fpicarras/hwsw-IST-24-25/lab1/prof_sources/app/image_conv2D_3ch_1ip.c

/**
 * @file image_conv2D.c
 * @date May, 2022
 *
 * Support file for lab1 of Hardware-Software Co-Design 2022
 *
 * Contains the baseline implementation of image convolution.
 */

#include <stdio.h>
#include <assert.h>
#include "image_conv2D_3ch_1ip.h"
#ifdef EMBEDDED
#include "xaxil_conv2d.h"
#endif

static unsigned char *ch_images;    /* images data region */
static unsigned char *image_in;     /* image to be processed */
static unsigned char *image_out;    /* output image */
static unsigned char *hw_image_out; /* output image computed using the hardware */

void sw_convolution_2D(const unsigned char *matrix_in, unsigned char *matrix_out) {
    for (int i = 0; i < OUTPUT_HEIGHT; i++)
        for (int j = 0; j < OUTPUT_WIDTH; j++) {
            int accum = bias;                       // initialize result with bias

            for (int k = 0; k < KERNEL_SIZE; k++)
                for (int x = 0; x < KERNEL_SIZE; x++) {
                    // Kernel index
                    int kernel_1d_idx =
                            k * KERNEL_SIZE +       // kernel row
                            x;                      // kernel column

                    // Input matrix index 
                    int input_1d_idx =
                            (i + k) * IMAGE_WIDTH + // input row
                            j + x;                  // input column

                    accum += kernel[kernel_1d_idx] * matrix_in[input_1d_idx];
                }

            // Normalize result
            if (accum > 255)
                accum = 255;
            else if (accum < 0)
                accum = 0;

            matrix_out[i * OUTPUT_WIDTH + j] = accum;
        }
}

void print_ppm(unsigned char *image, int height, int width, const char *prefix, int suffix){
#ifndef EMBEDDED
    char filename[STRING_LENGTH];
    sprintf(filename, "%s_image_%d.ppm", prefix, suffix);

    /* Open image file */
    FILE *image_file = fopen(filename, "wb");
    assert(image_file);

    printf("Printing %s image %d to file %s\n\r", prefix, suffix, filename);
#else
    FILE *image_file = stdout;
#endif //EMBEDDED

    /* Print binary PPM header */
    fprintf(image_file, "P6\n%d %d\n255\n", width, height);

    /* Write binary RGB pixel data */
    for (int i = 0; i < height; i++) {
         for(int j = 0; j < width; j++) {
             fputc(IMAGE_R(image, height, width, i, j), image_file);
             fputc(IMAGE_G(image, height, width, i, j), image_file);
             fputc(IMAGE_B(image, height, width, i, j), image_file);
        }
    }

    fprintf(image_file, "\n");


#ifndef EMBEDDED
    fclose(image_file);
#endif //EMBEDDED
}

void HWSW_conv2D(const unsigned char *matrix_in, unsigned char *matrix_out) {
#ifdef HLS_SIMULATION

    /* =====================================================================================
     * ======== DEVELOP THE HLS ROUTINE TO SIMULATE DE HARDWARE IP BELOW THIS LINE! ========
     * ===================================================================================== */
    sw_convolution_2D(matrix_in, matrix_out);
    sw_convolution_2D(matrix_in + IMAGE_HEIGHT*IMAGE_WIDTH, matrix_out + OUTPUT_HEIGHT*OUTPUT_WIDTH);
    sw_convolution_2D(matrix_in + 2*IMAGE_HEIGHT*IMAGE_WIDTH, matrix_out + 2*OUTPUT_HEIGHT*OUTPUT_WIDTH);

#elif defined(USE_HW_IP)
    /* =====================================================================================
     * ========== DEVELOP THE ROUTINE TO CONTROL DE HARDWARE IP BELOW THIS LINE! ===========
     * ===================================================================================== */    
    // Initialize temporary memmory
    unsigned int *tmp_in = (unsigned int *) MEM_INPUT_TMP_ADDRESS;
    unsigned int *tmp_out = (unsigned int *) MEM_OUTPUT_TMP_ADDRESS;
    unsigned int tmp;

    for(int i = 0; i < IMAGE_HEIGHT; i++){
        for(int j = 0; j < IMAGE_WIDTH; j++){
            tmp = (unsigned int) IMAGE_R(matrix_in, IMAGE_HEIGHT, IMAGE_WIDTH, i, j);
            tmp += ((unsigned int) IMAGE_G(matrix_in, IMAGE_HEIGHT, IMAGE_WIDTH, i, j)) << 8;
            tmp += ((unsigned int) IMAGE_B(matrix_in, IMAGE_HEIGHT, IMAGE_WIDTH, i, j)) << 16;
            tmp_in[i*IMAGE_WIDTH+j] = tmp;
        }
    }
    
    // Initialize IP
    XAxil_conv2d conv2d_0;
    XAxil_conv2d_Config *cfg_0;
    cfg_0 = XAxil_conv2d_LookupConfig(0x40000000);
    XAxil_conv2d_CfgInitialize(&conv2d_0, cfg_0);
    
    // Set Inputs on all channels
    while(!XAxil_conv2d_IsReady(&conv2d_0));    
    XAxil_conv2d_Write_image_in_Words(&conv2d_0, 0, tmp_in, IMAGE_HEIGHT * IMAGE_WIDTH);
    XAxil_conv2d_Write_weights_Bytes(&conv2d_0, 0, kernel, KERNEL_SIZE * KERNEL_SIZE);
    XAxil_conv2d_Set_bias(&conv2d_0, bias);
    XAxil_conv2d_Start(&conv2d_0);

    while(!XAxil_conv2d_IsDone(&conv2d_0));
    XAxil_conv2d_Read_image_out_Bytes(&conv2d_0, 0, tmp_in, 4*OUTPUT_HEIGHT*OUTPUT_WIDTH);

    for(int i = 0; i < OUTPUT_HEIGHT; i++){
        for(int j = 0; j < OUTPUT_WIDTH; j++){
            tmp = tmp_in[i*OUTPUT_WIDTH + j];
            IMAGE_R(matrix_out, OUTPUT_HEIGHT, OUTPUT_WIDTH, i, j) = (unsigned char)tmp;
            IMAGE_G(matrix_out, OUTPUT_HEIGHT, OUTPUT_WIDTH, i, j) = (unsigned char)(tmp >> 8);
            IMAGE_B(matrix_out, OUTPUT_HEIGHT, OUTPUT_WIDTH, i, j) = (unsigned char)(tmp >> 16);
        }
    }

#endif //HLS_SIMULATION/USE_HW_IP
}

int check_hw_errors() {
    int err_cnt = 0;
    for (int i = 0; i < (OUTPUT_HEIGHT * OUTPUT_WIDTH * 3); i++)
        if (hw_image_out[i] != image_out[i]) {
            err_cnt++;
            // printf("%d: %d != %d\n\r", i, hw_image_out[i], image_out[i]);
        }

    return err_cnt;
}

int main() {

    printf("Hi!\n");
    /* Performs memory assignment  */
    ch_images = (unsigned char *) MEM_IMAGES_BASE_ADDRESS;
    image_out = (unsigned char *) MEM_DATA_BASE_ADDRESS;
    hw_image_out = (unsigned char *) MEM_OUTPUT_BASE_ADDRESS;

#ifndef EMBEDDED
    /* Read images from file */
    FILE *images_file = fopen(IMAGES_FILENAME, "rb");
    assert(images_file);
    fread(ch_images, N_IMAGES * IMAGE_SIZE, 1, images_file);
    for(int i = 0; i < N_IMAGES * IMAGE_SIZE; i++) {
        printf("%x, ", ch_images[i]);
        if((i+1)%IMAGE_HEIGHT == 0) {
            printf("\n\n\n");
        }
    }
    fclose(images_file);
#endif //EMBEDDED

    /* Select input image */
    image_in = ch_images + (IMAGE_TO_CONVOLVE - 1) * IMAGE_SIZE;

#ifdef EMBEDDED
    XTime tStart, tEnd;
    XTime_GetTime(&tStart);
#endif //EMBEDDED

    /* Performs software convolution */
    sw_convolution_2D(image_in,
                      image_out);                                    /* Red channel */
    sw_convolution_2D(image_in + IMAGE_HEIGHT * IMAGE_WIDTH,
                      image_out + OUTPUT_HEIGHT * OUTPUT_WIDTH);     /* Green channel */
    sw_convolution_2D(image_in + 2 * IMAGE_HEIGHT * IMAGE_WIDTH,
                      image_out + 2 * OUTPUT_HEIGHT * OUTPUT_WIDTH); /* Blue channel */

#ifdef EMBEDDED
    XTime_GetTime(&tEnd);
    XTime tSW = tEnd - tStart;
#endif //EMBEDDED

#if defined(HLS_SIMULATION) || defined(USE_HW_IP)
#ifdef EMBEDDED
    XTime_GetTime(&tStart);
#endif //EMBEDDED

    /* Performs hardware convolution */
    printf("Running HW!\n");
    HWSW_conv2D(image_in,
                hw_image_out);                                    /* Red channel */
    printf("Done HW!\n");
    //HWSW_conv2D(image_in + IMAGE_HEIGHT * IMAGE_WIDTH,
    //            hw_image_out + OUTPUT_HEIGHT * OUTPUT_WIDTH);     /* Green channel */
    //HWSW_conv2D(image_in + 2 * IMAGE_HEIGHT * IMAGE_WIDTH,
    //            hw_image_out + 2 * OUTPUT_HEIGHT * OUTPUT_WIDTH); /* Blue channel */

#ifdef EMBEDDED
    XTime_GetTime(&tEnd);
    XTime tHW = tEnd - tStart;
#endif //EMBEDDED

    int errs = check_hw_errors();
#endif //HLS_SIMULATION || USE_HW_IP

#ifdef EMBEDDED
    printf("# SW Execution: %.2f ms.\n\r", (float) tSW * 1000 / (COUNTS_PER_SECOND));

#ifdef USE_HW_IP
    printf("# HW Execution: %.2f ms.\n\r", (float) tHW * 1000 / (COUNTS_PER_SECOND));
    printf("# Speedup: %.2f.\n\r", (float) tSW / tHW);
    printf("# Errors: %d\n\r", errs);
#endif //USE_HW_IP
#endif //EMBEDDED

#ifdef PRINT_IMAGE_IN
    print_ppm(image_in, IMAGE_WIDTH, IMAGE_HEIGHT, "input", IMAGE_TO_CONVOLVE);
#endif //PRINT_IMAGE_IN

    // for(int i = 0; i < OUTPUT_HEIGHT * OUTPUT_WIDTH; i++) {
    //     printf("%x, ", image_out[i]);
    //     if((i+1)%IMAGE_HEIGHT == 0) {
    //         printf("\n\n\n");
    //     }
    // }

#ifdef PRINT_IMAGE_OUT
    print_ppm(image_out, OUTPUT_HEIGHT, OUTPUT_WIDTH, "output", IMAGE_TO_CONVOLVE);
#endif //PRINT_IMAGE_OUT

#ifdef HLS_SIMULATION
    return errs;
#else
    return 0;
#endif
}
