fpicarras/hwsw-IST-24-25/app/gemm.h

#ifndef __GEMM_H__
#define __GEMM_H__

#include <stdint.h>

#define BLOCK_SIZE 32 // Block size for tiling

/**
 * Computes matrix multiplication using the GEMM kernel.
 * @param A Gathered matrix A
 * @param B Matrix B
 * @param C Output matrix
 * @param rowsA Rows of matrix A
 * @param colsA Columns of matrix A
 * @param colsB Columns of matrix B
 */
void gemm(const float *A, const float *B, float *C, int rowsA, int colsA, int colsB);

/**
 * Computes matrix multiplication using the GEMM kernel and sums with a bias.
 * @param A Gathered matrix A
 * @param B Matrix B
 * @param bias Bias
 * @param C Output matrix
 * @param rowsA Rows of matrix A
 * @param colsA Columns of matrix A
 * @param colsB Columns of matrix B
 */
void gemmBias(const int16_t *A, const int32_t *B, const int16_t* bias, float *C, int rowsA, int colsA, int colsB);


void gemvOpt(const int16_t *A, const int32_t *B, const int16_t* bias, int64_t *C);

void gemvOptT(const int16_t *A, const int32_t *B, const int16_t* bias, int64_t *C);

/**
 * Computes matrix multiplication using the GEMM kernel with second matrix transposed.
 * @param A Gathered matrix A
 * @param BT Matrix B transposed
 * @param C Output matrix
 * @param rowsA Rows of matrix A
 * @param colsA Columns of matrix A
 * @param rowsBT Rows of matrix B transposed (columns of matrix B)
 */
void gemmBT(const float *A, const float *BT, float *C, int rowsA, int colsA, int rowsBT);

/**
 * Computes matrix multiplication using the GEMM kernel with second matrix transposed.
 * and transposes the result.
 * @param A Gathered matrix A
 * @param BT Matrix B transposed
 * @param CT Output matrix (transposed)
 * @param rowsA Rows of matrix A
 * @param colsA Columns of matrix A
 * @param rowsBT Rows of matrix B transposed (columns of matrix B)
 */
void gemmBTCT(const float *A, const float *BT, float *CT, int rowsA, int colsA, int rowsBT);

/**
 * Transposes matrix.
 * @param C Input matrix
 * @param rows Rows of input matrix
 * @param cols Columns of input matrix
 * @param CT Output matrix (transposed input matrix)
 */
void transpose(const float *C, int rows, int cols, float *CT);

void transpose_int(const int16_t *C, int rows, int cols, int16_t * CT);

/**
 * Adds bias to all elements of the input matrix.
 * @param C Input matrix
 * @param rows Rows of input matrix
 * @param cols Columns of input matrix
 * @param bias Bias
 * @param Cbias Output matrix
 */
void add_bias(const float *C, int rows, int cols, const float *bias, float *Cbias);

/**
 * Applies ReLU to elements of input matrix.
 * @param C Input matrix
 * @param size Size of input matrix
 * @param Crl Output matrix
 */
void ReLU(const float *C, int size, float *Crl);

#endif // __GEMM_H__
