fpicarras/hwsw-IST-24-25/app/simple_cnn.c

/**
 * @file simple_cnn.c
 * @date May, 2022
 *
 * Support file for lab2 of Hardware-Software Co-Design 2022
 *
 * Contains the variables, constants, and routines related to the CNN model, as well as the main routine.
 *
 * NOTES:
 * 1) With the default memory management scheme, images.bin and weights.bin should
 *    be stored in the following memory locations:
 *    images.bin  -> 0x10000000
 *    weights.bin -> 0x11000000
 * 2) When generating the linker script, define heap and stack size at least:
 *    Heap Size  -> 10 kB
 *    Stack Size -> 10 kB
 */

#include <stdio.h>

#include "simple_cnn.h"
#include "cnn_sw.h"
#include "cnn_hw_sw.h"
#include "utils.h"
#ifdef EMBEDDED
#include "xaxidma.h"
#endif

void init_memory(addresses * addr) {
    /* Check if memory reserved for loading files is enough */
    assert(MEM_BIN_IMAGES >= MEM_CH_IMAGES);
    assert(MEM_BIN_PARAMS >= MEM_FP_PARAMS);

    /* Assign memory regions */
    addr->ch_images = (unsigned char *) MEM_BASE_ADDR;
    addr->fp_params = (float *) ((unsigned char *) addr->ch_images + MEM_BIN_IMAGES);
    addr->matA = (float *) ((unsigned char *) addr->fp_params + MEM_BIN_IMAGES);
    addr->matCv = (float *) ((unsigned char *) addr->matA + MEM_MAT_A);
    addr->matCbias = (float *) ((unsigned char *) addr->matCv + MEM_MAT_C_V);
    addr->matCrelu = (float *) ((unsigned char *) addr->matCbias + MEM_MAT_C_BIAS);
    addr->matCpool = (float *) ((unsigned char *) addr->matCrelu + MEM_MAT_C_RELU);
    addr->matConn = (float *) ((unsigned char *) addr->matCpool + MEM_MAT_C_POOL);
    addr->matConnB = (float *) ((unsigned char *) addr->matConn + MEM_MAT_CONN);
    addr->matSoftM = (float *) ((unsigned char *) addr->matConnB + MEM_MAT_CONN_B);

    addr->int_params = (int16_t*) (MEM_HW_BASE_ADDR);
    addr->matGemm = (int64_t*) ((unsigned char*) addr->int_params + MEM_BIN_PARAMS);
    addr->matSoftMax = (float*) ((unsigned char*) addr->matGemm + MEM_MAT_CONN2);

    addr->matConvPool[0] = (int32_t*) (CONVPOOL_BASE_ADDR);
    addr->matConvPool[1] = (int32_t*) (CONVPOOL2_BASE_ADDR);
    addr->matConvPoolInd = 0;

    addr->fp_images = (float *) IMAGES_BASE_ADDR;
    addr->int_images = (int16_t *) ((unsigned char *) addr->fp_images + 4*MEM_BIN_IMAGES);

    /* Load images and weights from files if running in PC */
#ifndef EMBEDDED
    FILE *weights_file = fopen(WEIGHTS_FILENAME, "rb");
    assert(weights_file);
    fread((float *) addr->fp_params,
          TOTAL_PARAMS,
          sizeof(float),
          weights_file);
    fclose(weights_file);

    weights_file = fopen(WEIGHTS_Q15_FILENAME, "rb");
    assert(weights_file);
    fread((int16_t *) addr->int_params,
          TOTAL_PARAMS,
          sizeof(int16_t),
          weights_file);
    fclose(weights_file);

    FILE *images_file = fopen(IMAGES_FILENAME, "rb");
    assert(images_file);
    fread((float *) addr->ch_images,
          N_IMAGES * IMAGE_SIZE,
          sizeof(unsigned char),
          images_file);
    fclose(images_file);
#else
    for (int i = 0; i < (CONV_LAYER_PARAMS + FC_LAYER_BIASES); i++) {
        addr->int_params[i] = float2fixed(addr->fp_params[i], 15);
    }
    for(int k = 0; k < CONV_OFM_NUMBER*N_CLASSES; k ++)
        for (int i = 0; i < POOL_OUTPUT_HEIGHT; i++) {
            for (int j = 0; j < POOL_OUTPUT_WIDTH; j++) {
                int ind_hw = k * HW_MATRIX_OUT_HEIGHT * HW_MATRIX_OUT_WIDTH + i * HW_MATRIX_OUT_WIDTH + j + (CONV_LAYER_PARAMS + FC_LAYER_BIASES);
                int ind_sw = k * POOL_OUTPUT_HEIGHT * POOL_OUTPUT_WIDTH + i * POOL_OUTPUT_WIDTH + j + (CONV_LAYER_PARAMS + FC_LAYER_BIASES);
                addr->int_params[ind_hw] = float2fixed(addr->fp_params[ind_sw], 15);
            }
            int ind_hw = k * HW_MATRIX_OUT_HEIGHT * HW_MATRIX_OUT_WIDTH + i * HW_MATRIX_OUT_WIDTH + POOL_OUTPUT_WIDTH + (CONV_LAYER_PARAMS + FC_LAYER_BIASES);
            addr->int_params[ind_hw] = 0;
        }
    Xil_DCacheFlushRange((INTPTR)addr->ch_images, MEM_BIN_IMAGES);
    Xil_DCacheFlushRange((INTPTR)addr->int_params, MEM_BIN_PARAMS);
#endif // EMBEDDED
}

int main() {
    printf("Start!\n");
    addresses addr;
    /* Performs memory assignment */
    init_memory(&addr);

    predict_images_sw(&addr);
    predict_images_hw_sw(&addr);
    return 0;
}
