fpicarras/hwsw-IST-24-25/(commit log)

2025-05-14 Removing Vitis files
    [hls_config.cfg]
2025-05-15 Fixing printds
2025-05-24 Fixing some bugs in conv2D
    [axil_conv2D.cpp, axil_conv2D.h, tb_axil_conv2D.cpp]
2025-05-24 Fixing conv2D and adding int tb files
    [tb_axil_conv2D.cpp, tb_axil_conv2D_int.cpp, tb_axil_conv2D_int.h]
2025-05-24 Fixing conv3D for ints
    [axil_conv3D.cpp, tb_axil_conv3D.cpp]
2025-05-27 Fixing fp tb for OFM=2 and IMAGE=88 and initial driver code
    [axil_conv3D.h, gemm.c, gemm.h, simple_cnn.c, simple_cnn.h, tb_axil_conv3D.cpp, utils.c, utils.h]
2025-05-28 Fixing some bugs in hw-sw conv3d base code
    [cnn_hw_sw.c, simple_cnn.c, simple_cnn.h]
2025-05-28 Trying to fix tb
    [tb_axil_conv3D.cpp]
2025-05-28 Fixing IP with image input and output with 16 bits
    [axil_conv3D.cpp, axil_conv3D.h, tb_axil_conv3D.cpp]
2025-05-28 Fixing app to use 16 bits in input images
    [app_params.h, cnn_hw_sw.c, cnn_hw_sw.h, image.c, image.h, simple_cnn.c]
2025-05-28 Fixing app to use 32 bits in output images
    [app_params.h, axil_conv3D.h, cnn_hw_sw.c, cnn_hw_sw.h, gemm.c, gemm.h, simple_cnn.c, tb_axil_conv3D.cpp]
2025-05-29 Optimizing DMA usage
2025-05-29 Initializing DMA once and improving tb code
2025-05-29 Optimizing DMA read of images
2025-05-31 Separating prediction printfs from execution time measurement
2025-06-02 Fixing axil conv3D 2 maxpool
    [axil_conv3D.cpp, axil_conv3D.h, tb_axil_conv3D.cpp]
2025-06-03 Renaming variables and fixing hw_matrix_out limits
    [axil_conv3D.cpp, axil_conv3D.h, tb_axil_conv3D.cpp]
2025-06-04 64 bits not working
    [axil_conv3D.cpp, axil_conv3D.h]
2025-06-06 Fixing 2 maxpool IP
    [axil_conv3D.cpp]
2025-06-11 Fixing N images in HLS testbench
    [axil_conv3D.h]
